JaeyunKim62/OFBGlove/plan.md

# OFBGlove 프로젝트 구현 계획

## 1단계: 웹 시각화 도구 개선 (우선순위: 높음)
- [ ] 구분자 마커 및 토큰 관련 코드 수정
- [ ] README 문서화 개선 (점자간 = 점자 셀 하나 단위 명확화)
- [ ] 사용자 인터랙션 개선
  - [ ] 다시듣기 기능 (기본 동작)
  - [ ] 다음/이전 네비게이션 버튼 (점자셀 하단 배치)
  - [ ] 구분자별 시간 텀 최적화 설정 UI

## 2단계: 점자 입력 시스템 구현 (우선순위: 높음)
- [ ] 웹 시각화 도구 점자 입력 구현
  - [ ] 6점 점자 순차 클릭 인터페이스
  - [ ] 점자 셀 단위별 통신 전송
  - [ ] 기존 구현 방식(application) 참고하여 통합
- [ ] 웹-앱 간 통신 프로토콜 구현

## 3단계: 음성 입력 시스템 개선 (우선순위: 높음)
- [ ] 음성 입력 시작/종료 버튼 개선
- [ ] 텍스트 변환 결과 표시 및 전송 결정 UI
- [ ] 시청각장애인 입력 형식 통신 처리

## 4단계: 고급 기능 및 UI/UX 개선 (우선순위: 낮음)
- [ ] 전체 문장 재생 + 문장별 다시듣기
- [ ] 고급 설정 옵션
- [ ] UI/UX 전반적 개선

## 5단계: 통신 방식
- [ ] tcp 외 다른 방식
- [ ] ble, udp 등
