JaeyunKim62/OFBGlove/web_visualizer/plan.md

# 웹 시각화 도구 개발 계획

## 현재 구현해야 할 기능

### 1. 사용자 인터랙션 개선 ✅ 완료
- [x] **기본 동작**: 단어단위 무한 반복
- [x] **네비게이션 버튼**: 다음/이전 단어 이동 (점자셀 하단 배치)

### 2. 점자 입력 시스템 ✅ 완료
- [x] **6점 점자 입력 인터페이스**
  - 순차적 클릭 방식 (한 번에 하나씩)
  - 점자 패턴 시각적 피드백
  - 입력 완료 시 다음 점자로 자동 이동
- [x] **통신 구현**
  - 점자 셀 단위별 실시간 전송
  - application과 동일한 프로토콜 사용

### 3. 문서화 개선 ✅ 완료
- [x] **README 업데이트**
  - "점자간" 용어 정의 명확화 ex) 알파벳
  - 사용법 가이드 추가
  - 기술적 세부사항 문서화

## 추후 구현 계획

### 구분자 및 타이밍 최적화 ✅ 완료
- [x] **구분자별 시간 텀 설정 UI**
  - 점자간 (점자 셀 하나 단위): 기본값 500ms
  - 단어간: 기본값 800ms
  - 문장간: 기본값 1200ms
- [x] **설정값 시각적 표시**
  - 현재 설정값을 명확하게 보여주는 UI
  - 실시간 미리보기 기능
 
### 고급 기능
- [ ] **전체 문장 재생**
  - 기본: 전체 문장 들려주기
  - 다시듣기: 현재/이전 문장 선택적 재생
- [ ] **고급 설정**
  - 속도 조절
  - 음성 설정
  - 접근성 옵션

### UI/UX 개선
- [ ] 반응형 디자인
- [ ] 다크모드 지원
- [ ] 키보드 단축키
- [ ] 접근성 표준 준수
