JaeyunKim62/OFBGlove/vibration_module/hardware/vibration_module.step

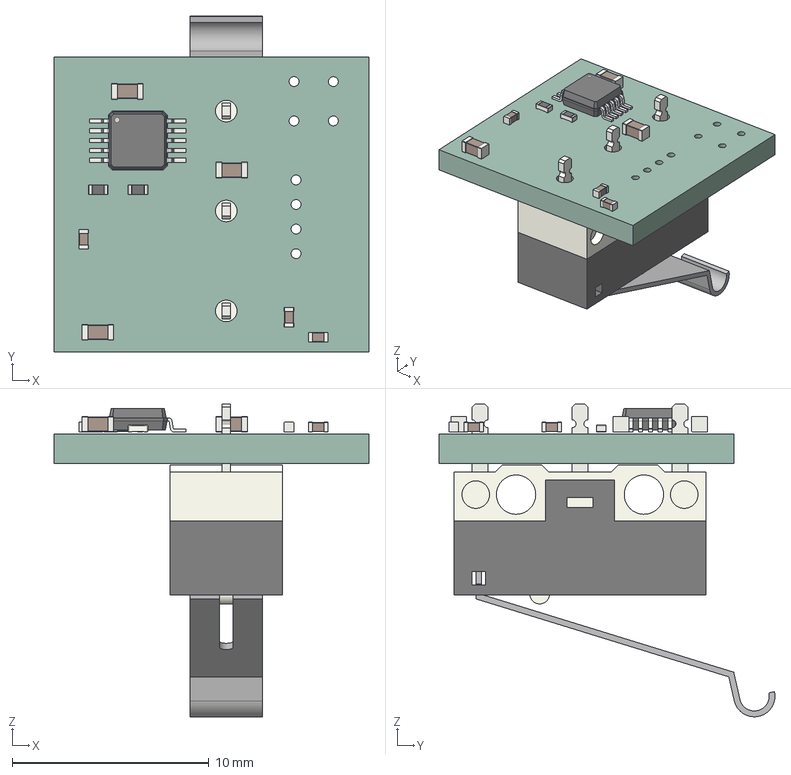
[picture p1: CAD file, 2025-10-24]
vibration_module/hardware/vibration_module.step
16.0 x 17.1 x 15.9 mm
C_0402_1005Metric x 3
R_0402_1005Metric x 2
C_0603_1608Metric x 3
VSSOP-10_3x3mm_P0.5mm
Bottom001
Top001
Plunger001
Lever_16U001
Pin_NO005
Pin_C005
Pin_NC005
vibration_module_PCB
