JaeyunKim62/OFBGlove/vibration_module/hardware/vibration_module.kicad_pcb

## KiCad design vibration_module/hardware/vibration_module.kicad_pcb (2025-11-13)

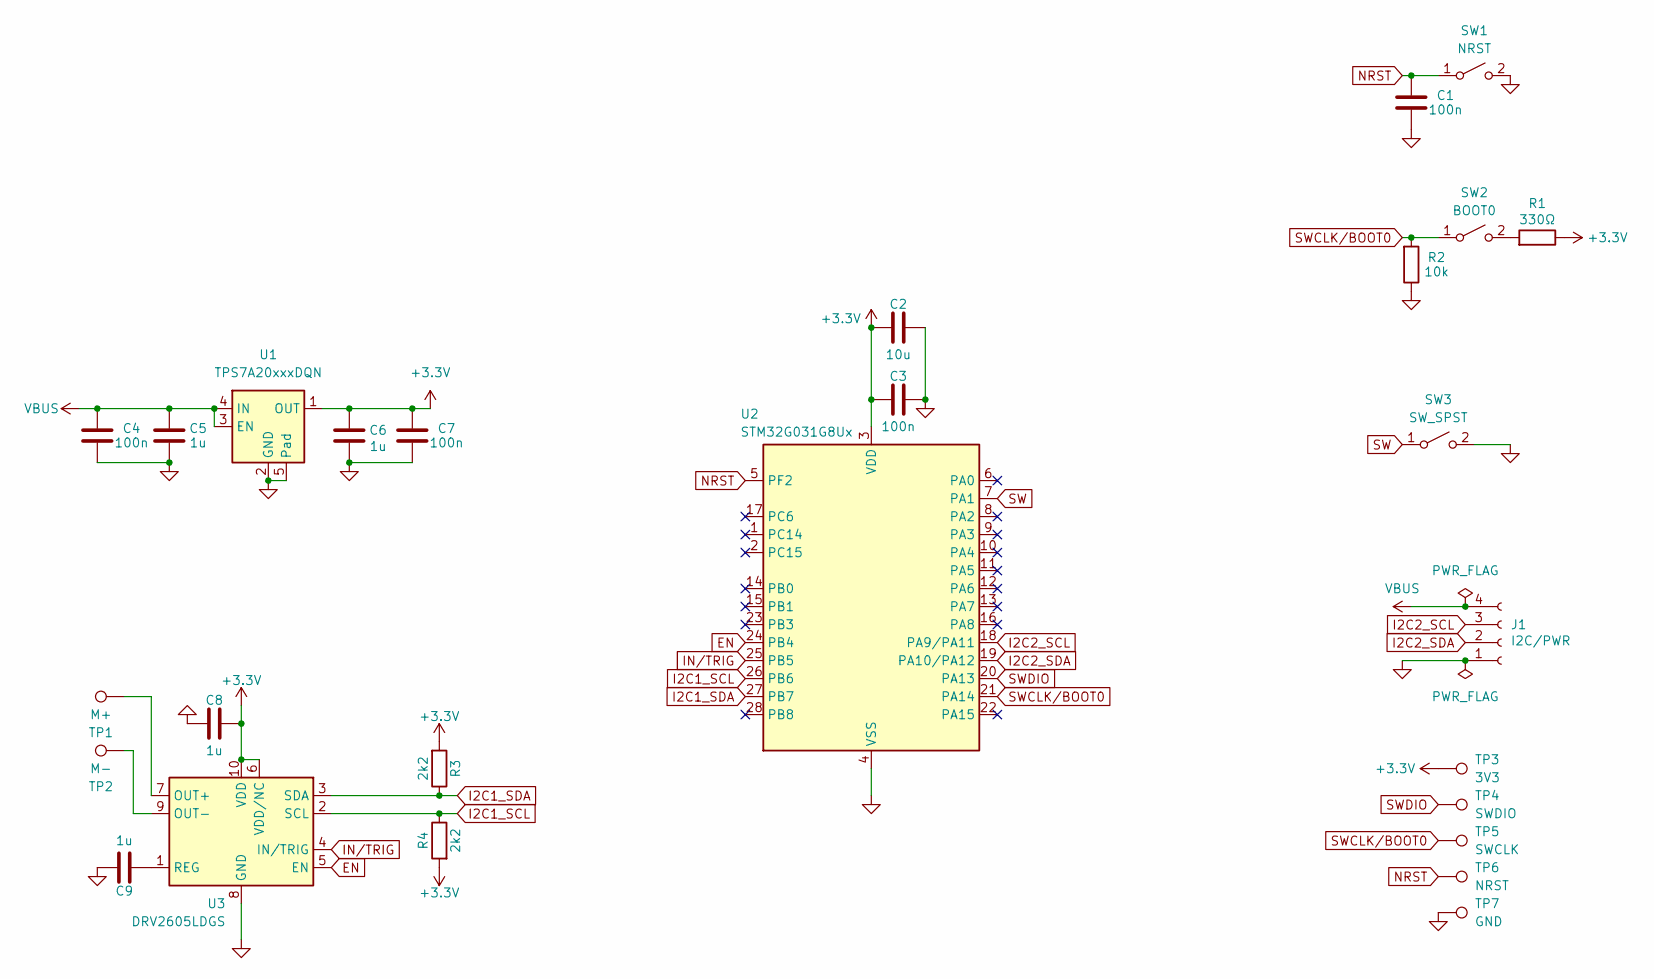
[picture p2: schematic vibration_module.kicad_sch]

Parts:
C1, C3, C4, C7: 100n; C_0402_1005Metric
C2: 10u; C_0603_1608Metric
C5, C6: 1u; C_0402_1005Metric
C8, C9: 1u; C_0603_1608Metric
J1: I2C/PWR; Molex_PicoBlade_53261-0471_1x04-1MP_P1.25mm_Horizontal
R1: 330Ω; R_0402_1005Metric
R2: 10k; R_0402_1005Metric
R3, R4: 2k2; R_0402_1005Metric
SW1: NRST; SW_TS-1088-AR02016
SW2: BOOT0; SW_TS-1088-AR02016
SW3: SW_SPST; SW_TS-1088-AR02016
TP1: M+; TestPoint_THTPad_1.0x1.0mm_Drill0.5mm
TP2: M-; TestPoint_THTPad_1.0x1.0mm_Drill0.5mm
TP3: 3V3; TestPoint_Pad_D1.0mm
TP4: SWDIO; TestPoint_Pad_D1.0mm
TP5: SWCLK; TestPoint_Pad_D1.0mm
TP6: NRST; TestPoint_Pad_D1.0mm
TP7: GND; TestPoint_Pad_D1.0mm
U1: TPS7A20xxxDQN; Texas_X2SON-4_1x1mm_P0.65mm
U2: STM32G031G8Ux; QFN-28_4x4mm_P0.5mm
U3: DRV2605LDGS; VSSOP-10_3x3mm_P0.5mm

Connections:
+3.3V: C2.1, C3.1, C6.2, C7.2, C8.1, R1.1, R3.2, R4.2, TP3.1, U1.1 (OUT), U2.3 (VDD), U3.6 (VDD/NC), U3.10 (VDD)
EN: U2.24 (PB4), U3.5 (EN)
GND: C1.1, C2.2, C3.2, C4.1, C5.1, C6.1, C7.1, C8.2, C9.1, J1.1, R2.1, SW1.2 (B), SW3.2 (B), TP7.1, U1.2 (GND), U1.5 (Pad), U2.4 (VSS), U3.8 (GND)
I2C1_SCL: R4.1, U2.26 (PB6), U3.2 (SCL)
I2C1_SDA: R3.1, U2.27 (PB7), U3.3 (SDA)
I2C2_SCL: J1.3, U2.18 (PA9/PA11)
I2C2_SDA: J1.2, U2.19 (PA10/PA12)
IN/TRIG: U2.25 (PB5), U3.4 (IN/TRIG)
NRST: C1.2, SW1.1 (A), TP6.1, U2.5 (PF2)
unnamed: R1.2, SW2.2 (B)
unnamed: TP1.1, U3.7 (OUT+)
unnamed: TP2.1, U3.9 (OUT-)
unnamed: C9.2, U3.1 (REG)
SW: SW3.1 (A), U2.7 (PA1)
SWCLK/BOOT0: R2.2, SW2.1 (A), TP5.1, U2.21 (PA14)
SWDIO: TP4.1, U2.20 (PA13)
VBUS: C4.2, C5.2, J1.4, U1.3 (EN), U1.4 (IN)

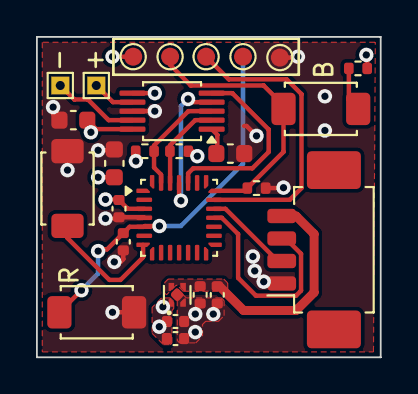
[picture p3: board vibration_module.kicad_pcb from above]

Board: 4 copper layers, 19.1 x 17.8 mm, 27 parts (0 on the bottom side), 17 nets.
