JaeyunKim62/OFBGlove/vibration_module/firmware/Core/Inc/main.h

#define BTN_IN_Pin GPIO_PIN_1
#define BTN_IN_GPIO_Port GPIOA
#define VIB_EN_Pin GPIO_PIN_4
#define VIB_EN_GPIO_Port GPIOB
#define VIB_TRIG_Pin GPIO_PIN_5
#define VIB_TRIG_GPIO_Port GPIOB
