JaeyunKim62/OFBGlove/vibration_module/firmware/Core/Src/main.c

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
/* Includes ------------------------------------------------------------------*/
#include "main.h"

/* USER CODE BEGIN Includes */
#include <stdint.h>
#include <stdbool.h>
#include <stdio.h>
#include "drv2605.h"
#include "host_protocol.h"
/* USER CODE END Includes */

I2C_HandleTypeDef hi2c1;
I2C_HandleTypeDef hi2c2;

UART_HandleTypeDef huart2;

void SystemClock_Config(void);
static void MX_GPIO_Init(void);
static void MX_I2C1_Init(void);
static void MX_I2C2_Init(void);
static void MX_USART2_UART_Init(void);
/* USER CODE BEGIN 0 */
#if defined(SEMIHOSTING_ENABLED)
extern void initialise_monitor_handles(void);

static inline void semihost_init(void) {
  initialise_monitor_handles();
}

static inline void semihost_log(const char *message) {
  puts(message);
}
#else
static inline void semihost_init(void) {}

static inline void semihost_log(const char *message) {
  (void)message;
}
#endif

static bool vib_playing = false;
static uint32_t vib_started_at = 0U;
static const uint8_t button_pattern[] = {DRV2605_EFFECT_STRONG_CLICK_100};
static const uint8_t button_pattern_length = (uint8_t)sizeof(button_pattern);

static bool btn_is_pressed(void) {
  return HAL_GPIO_ReadPin(BTN_IN_GPIO_Port, BTN_IN_Pin) == GPIO_PIN_RESET;
}

static void start_vibration(const uint8_t *effects, uint8_t length) {
  if (effects == NULL || length == 0U) {
    return;
  }
  drv2605_load_sequence(effects, length);
  drv2605_play();
  vib_playing = true;
  vib_started_at = HAL_GetTick();
}

/* USER CODE END 0 */

/**
  * @brief  The application entry point.
  * @retval int
  */
int main(void)
{

  /* MCU Configuration--------------------------------------------------------*/

  /* Reset of all peripherals, Initializes the Flash interface and the Systick. */
  HAL_Init();

  /* Configure the system clock */
  SystemClock_Config();

  /* Initialize all configured peripherals */
  MX_GPIO_Init();
  MX_I2C1_Init();
  MX_I2C2_Init();
  MX_USART2_UART_Init();
  /* USER CODE BEGIN 2 */
  semihost_init();
  semihost_log("Hello from semihosting!");
  const drv2605_config_t drv2605_config = {
      .hi2c = &hi2c1,
      .enable_port = VIB_EN_GPIO_Port,
      .enable_pin = VIB_EN_Pin,
  };
  drv2605_init(&drv2605_config);
  host_if_init(&hi2c2);
  const uint32_t playback_timeout_ms = 1000U;
  const uint32_t button_poll_interval_ms = 5U;
  const uint32_t button_debounce_ms = 20U;

  bool btn_state = btn_is_pressed();
  bool btn_latched = btn_state;
  uint32_t btn_last_change = HAL_GetTick();
  /* USER CODE END 2 */

  /* Infinite loop */
  /* USER CODE BEGIN WHILE */
  while (1) {
    /* USER CODE END WHILE */

    /* USER CODE BEGIN 3 */
    bool current_state = btn_is_pressed();
    if (current_state != btn_state) {
      btn_state = current_state;
      btn_last_change = HAL_GetTick();
    }

    bool stable_pressed =
        btn_state && (HAL_GetTick() - btn_last_change) >= button_debounce_ms;

    if (!stable_pressed) {
      btn_latched = false;
    }

    bool stop_requested = host_if_take_stop_request();
    if (stop_requested && vib_playing) {
      semihost_log("Host stop request received. Stopping vibration.");
      drv2605_stop();
      vib_playing = false;
    }

    if (vib_playing) {
      bool driver_busy = drv2605_is_busy();
      bool timed_out = (HAL_GetTick() - vib_started_at) >= playback_timeout_ms;
      if (!driver_busy || timed_out) {
        if (timed_out) {
          semihost_log("Vibration timeout hit. Forcing stop.");
          drv2605_stop();
        }
        vib_playing = false;
      }
    } else {
      host_if_pattern_t host_pattern;
      if (host_if_take_play_request(&host_pattern)) {
        semihost_log("Host pattern received. Triggering vibration.");
        start_vibration(host_pattern.effects, host_pattern.length);
      } else if (stable_pressed && !btn_latched) {
        semihost_log("Button press detected. Triggering vibration.");
        start_vibration(button_pattern, button_pattern_length);
        btn_latched = true;
      }
    }

    host_if_update_runtime_state(stable_pressed, vib_playing);
    HAL_Delay(button_poll_interval_ms);
  }
  /* USER CODE END 3 */
}

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
