JaeyunKim62/OFBGlove/(commit log)

2025-10-24 add Keyboard vibration module to mono repo (#1)
    * initial commit
    * mouse switch integration
    * change proj structure
    * keyboard version poc
    * fix proj structure
    * intermediate comit.
    * chore: reorganize repo into monorepo structure
    [BOM-vibration_module.csv, bom.csv, designators.csv, positions.csv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]
2025-10-25 feat: implement navigation and replay features for Braille sequences
    - Added navigation controls for previous and next Braille cells.
    - Implemented replay functionality for current sentence and entire Braille sequence.
    - Introduced user interface elements for word navigation and automatic word repeat settings.
    - Enhanced separator optimization settings for customizable delays between word, sentence, and Braille separators.
    - Updated README to reflect new features and usage instructions.
2025-10-26 feat: implement Braille input component and enhance user interaction
    - Added Braille input component for real-time pattern entry with visual feedback.
    - Improved user interaction by completing features for navigation buttons and Braille input system.
    - Updated styles for Braille input section and buttons for better usability.
    - Enhanced documentation in plan.md to reflect completed features and future plans.
2025-10-29 feat: enhance current sentence sequence handling and update space character representation
2025-10-29 feat: add navigation buttons for word navigation
    - Introduced navigation buttons for previous and next word navigation in the App component.
2025-10-30 feat: add glove image
    - Added glove background adjustment controls for positioning, scaling, and opacity.
    - Implemented web input buffering for Braille patterns before sending.
    - Updated demo plan to include support for displaying current word and full sentence in both English and Korean.
    - Enhanced BrailleInput component to support new functionality and improved user interaction.
2025-10-30 refactor: update Braille representation
    - Removed glove background adjustment controls from the App component.
    - Updated Braille representation for space character from "공백" to "⌴".
    - Adjusted styles in BrailleInput component for improved layout and appearance.
    - Added new glove image for visualization.
2025-10-30 refactor: simplify App component layout and navigation controls
    - Updated grid layout in App.css for consistent column proportions.
    - Removed large navigation buttons and word navigation controls for a cleaner demo presentation.
    - Adjusted labels in the text output section for clarity.
2025-10-30 feat: enhance word committing functionality in App and BrailleInput components
    - Implemented logic to commit words to the current sentence upon double-clicking.
2025-10-30 refactor: update layout and styles in voice input
    - Adjusted grid layout in App.css for better column proportions.
    - Increased spacing and font sizes in various components for enhanced readability.
    - Updated the current sentence section to focus on received sentences only, filtering out web sources.
    - Enhanced styling for sentence display elements, including padding, margins, and background colors.
2025-10-30 feat: enhance voice input functionality in ChatScreen and ViewModel
    - Implemented button hold feature for starting and stopping voice recognition.
    - Added pending recognized text handling with options to send or cancel.
    - Updated ChatScreen and ViewModel to manage new voice message states and actions.
2025-10-30 feat: rollback voice input to click button
2025-11-06 feat: implement OCR functionality for 필담 이미지 processing
    - Apply the process in Test images
    - Added OcrResultListener interface for asynchronous OCR result handling.
    - Created TextRecognizerManager class to manage ML Kit text recognition, including image preprocessing.
    - Integrated OCR processing into ChatViewModel to handle received images and convert them to chat messages.
    - Established WiFi service image reception callback in MainActivity for real-time OCR processing.
    - Included test images for OCR functionality testing.
2025-11-06 feat: implement ESP32 TCP server for connecting app
    - Added ESP_APP_COMMUNICATION.md to define the communication protocol between ESP and Android app.
    - Developed ESP32 TCP server to handle Braille pattern input and output, including image data transmission.
    - Implemented message types and checksum calculations for reliable data transfer.
    - Established WiFi connection and TCP server setup for client communication.
2025-11-06 refactor: remove unused onSend prop from BrailleInput component
2025-11-12 feat: fix protocol for braille sequence transmission
    - Added functionality to send multiple braille patterns as a single sequence using the new BRAILLE_SEQUENCE message type.
    - Updated ChatViewModel to collect and send braille patterns efficiently.
    - Enhanced UnifiedMessageManager and WifiBrailleTransmitter to handle the new sequence transmission.
    - Implemented data validation and logging for received braille sequences in the ESP32 server and web visualizer.
2025-11-12 fix: Handle consecutive same characters in braille patterns
    - Fix duplicate detection that filtered consecutive same patterns
2025-11-13 feat: enhance TCP data handling with buffer management
    - Introduced a new buffer management system for TCP sockets to handle incoming data more efficiently.
    - Replaced the existing processTCPData method with processTCPBuffer to process complete messages from the buffer.
    - Added functionality to initialize and manage buffers for each TCP client, ensuring proper message handling and checksum validation.
2025-11-13 chore: remove obsolete files related to ESP32 communication
2025-11-13 feat: implement ESP32 TCP server for braille data reception
    - Added a new ESP32 server to handle TCP connections and receive braille data.
    - Use AP to connect TCP
    - Debug messages showing in serial monitor
2025-11-13 add i2c protocol
2025-11-13 feat: send braille pattern to app
    - Added functions to handle serial input and send patterns over TCP.
    - Improved message parsing and error handling for received data.
    - Updated debug logging for better traceability of operations.
    [esp_server.ino]
2025-11-13 feat: implement motor control for braille patterns
    - Added functions to initialize and control motors for braille dot patterns using I2C communication.
    - Implemented commands to play and stop patterns, along with status reading for motor feedback.
    - Enhanced logging for motor statuses and error handling during I2C operations.
    - Updated existing functions to integrate motor control with pattern application and message handling.
    [esp_server.ino]
2025-11-13 vibration module feature complete
    [host_protocol.h, main.c]
2025-11-13 fix: update braille dot addresses and default parameters
    [esp_server.ino]
2025-11-13 feat: add dot each button signal to Braille converter and learning examples
    - Updated BrailleConverter to include mappings for Korean characters 'ㄱ' to 'ㅂ'.
    - Added new LearningExample entries for each Korean character with corresponding descriptions.
2025-11-18 feat: add button press detection and communication to ESP server
    - Introduced a new message type for button presses.
    - Implemented button state tracking and detection logic.
    - Added functionality to send button press events to the client.
    - Updated loop to periodically check button states.
2025-11-18 fix: integrate handleKeyboardTest into main loop for continuous input handling
    [esp_server.ino]
2025-11-18 fix: enhance input handling in handleKeyboardTest to ignore newline characters
    - Added logic to skip processing for newline and carriage return key presses, improving the robustness of keyboard input handling.
    [esp_server.ino]
2025-11-18 feat: enable motor status debugging in ESP server
2025-11-18 feat: extend keyboard input handling (next button) in handleKeyboardTest for braille patterns
    - Added support for keys '1', '2', and '3' to return a specific dot order for next button.
2025-11-18 feat: add test that button input express to braille haptic output
    - Implemented handleButtonIOTest function to manage button presses for braille input.
    - express haptic mapping the button presses
2025-11-18 feat: next button command change to 6-5
2025-11-19 feat: send the braille pattern to client
    - Added handleButtonToClient function to manage button presses for braille input.
    - Updated sendButtonPressToClient function to send braille patterns instead of button presses.
    - Refactored button state handling logic to improve clarity and functionality.
2025-11-19 feat: implement sequential vibration pattern for noticing glove setup
    - Added playSequentialVibration function to execute a series of vibrations corresponding to braille dots.
    - Integrated sequential vibration call in motor initialization and access point startup for immediate feedback.
    - Introduced delays to manage vibration duration and intervals between dots.
    [esp_server.ino]
2025-11-19 feat: add vibration configuration management to ESP server in outside manger
    - Introduced VibrationConfig struct to manage vibration settings including waveform, pattern length, hold duration, intensity, speed, and mode.
    - Implemented functions to apply, get, set, and reset vibration configurations via TCP messages.
    - Added new message types for configuration management: MSG_CONFIG_SET, MSG_CONFIG_GET, and MSG_CONFIG_RESET.
    [esp_server.ino]
2025-11-19 feat: apply vibration control with configurable speed and pattern handling
    - Change the value to using VibrationConfig in functions
    - Added constants for vibration speed hold and interval durations to improve control over vibration patterns.
    - Updated applyBraillePattern function to dynamically use the current configuration's pattern length and waveform ID.
    - Modified handleWordSequence to utilize configurable hold and interval durations for better timing in vibration feedback.
    - Introduced new message types for configuration management in the ESP server.
    [esp_server.ino]
2025-11-19 fix: relocated codes to fix definition error
    [esp_server.ino]
2025-11-19 feat: enhance button handling for braille input with long-press functionality
    - Introduced long-press detection for button 6 to commit braille patterns.
    - Improved button state management to differentiate between button 6 and other buttons.
    - Updated logic to handle button state changes and reset timers appropriately.
    - Enhanced feedback for button presses, including serial output for debugging.
    [esp_server.ino]
2025-11-19 fix: relocated the struct
    [esp_server.ino]
2025-11-20 fix: send braillepattern packet to app from esp
    [esp_server.ino]
2025-11-26 feat: add glove control panel for dynamic adjustments
    - Introduced a control panel for adjusting glove properties such as position, size, opacity, and rotation.
    - Added a button to toggle the visibility of the control panel.
    - Updated the BrailleInput component to accommodate the new rotation property for the glove background.
    - Enhanced CSS for glove background styling and positioning.
2025-11-26 feat: implement braille text display functionality
    - Added functions to convert characters to braille patterns and display them sequentially.
    - Introduced a control panel with buttons to trigger the display of predefined text in braille.
    - Enhanced user interaction by providing visual feedback during the display process.
2025-11-26 feat: add dot-by-dot display mode for braille patterns
    - Introduced a new state to toggle between dot-by-dot and standard braille display modes.
    - Implemented a function to display braille dots sequentially, enhancing the visual representation of braille characters.
    - Updated the text display function to utilize the new dot-by-dot mode based on user selection.
    - Enhanced the control panel with a button to switch between display modes, improving user interaction.
2025-12-04 docs: add communication interface design document
    - Introduced a new document outlining the design for the communication interface in the Android app.
    - Details the purpose, problems with the current implementation, and proposed solutions.
    - Includes interface design specifications and implementation phases for improved extensibility and maintainability.
2025-12-04 feat: add dot mode and interval configuration for vibration patterns
    - Introduced dotMode and dotInterval parameters to the VibrationConfig structure, allowing for new vibration patterns.
    - Updated handleConfigGet and handleConfigSet functions to manage the new configuration options.
    - Enhanced applyBraillePattern function to support both CELL and DOT_BY_DOT modes for vibration activation.
    - Adjusted payload length in communication to accommodate new parameters.
    [esp_server.ino]
2025-12-04 feat: update ESP server configuration and enhance vibration pattern handling
    - Changed I2C SDA and SCL pins to 22 and 23, respectively.
    - Updated access point SSID to "OFBG_AP7".
    - Increased payload size for configuration handling.
    - Improved dot mode handling in applyBraillePattern function to include timing adjustments and ensure proper motor activation.
    - Added delays for better control of vibration patterns in DOT_BY_DOT mode.
    [esp_server.ino]
2025-12-04 feat: implement TCP and WebSocket protocol handlers
    - Added TcpProtocolHandler for handling binary communication with Android/ESP32 devices over TCP.
    - Introduced WebSocketProtocolHandler for managing WebSocket connections with web clients using JSON protocol.
    - Created a base ProtocolHandler class to abstract common functionalities for both TCP and WebSocket handlers.
    - Implemented methods for starting/stopping servers, handling client connections, and message processing.
2025-12-04 feat: add MessageBridge for TCP and WebSocket message conversion
    - Implemented MessageBridge class to handle conversion between binary messages from TCP/ESP32 and JSON messages for WebSocket clients.
    - Added methods for binaryToJson and jsonToBinary to facilitate message processing.
    - Included utility functions for parsing and packing braille patterns, enhancing communication between devices.
2025-12-04 feat: implement refactored BrailleServer for integrated TCP and WebSocket communication
    - Created BrailleServer class to manage TCP and WebSocket protocol handlers.
    - Established a message bridge for converting and relaying messages between TCP and WebSocket clients.
    - Implemented client connection management and special message handling for enhanced communication.
    - Added methods for updating braille state and broadcasting client updates, improving overall server functionality.
